wizardpb/2057-ICE40HX4K-TQ144-breakout/2057-ICE40HX4K-TQ144-breakout.kicad_pcb

## KiCad design 2057-ICE40HX4K-TQ144-breakout.kicad_pcb (2026-07-26)

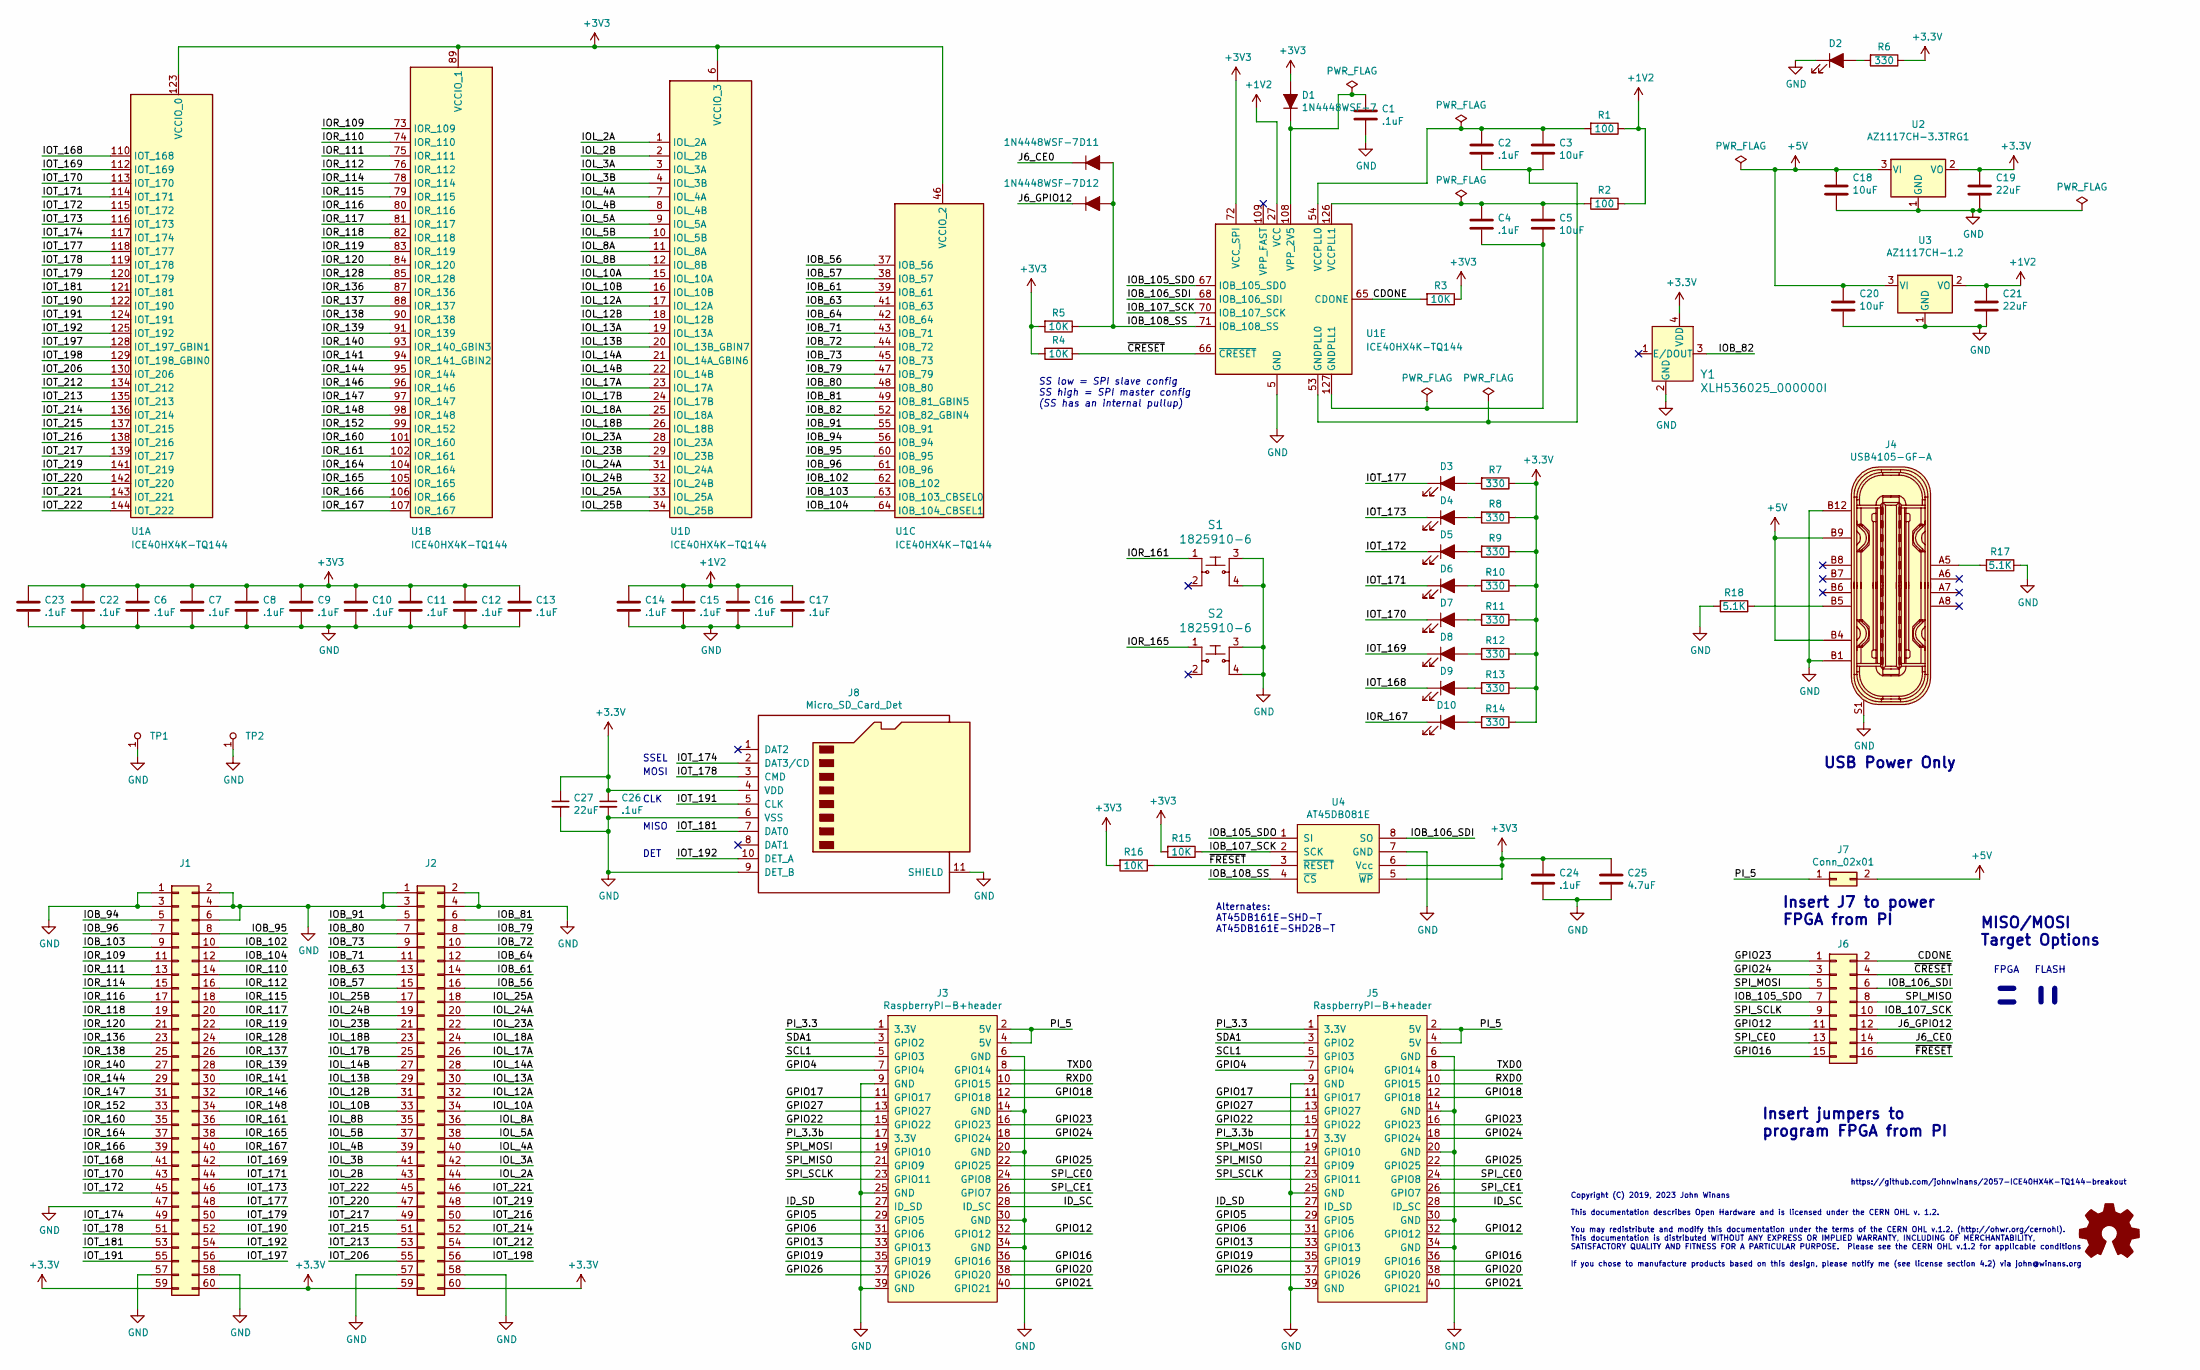
[picture p1: schematic 2057-ICE40HX4K-TQ144-breakout.kicad_sch]

Parts:
C1, C2, C4, C6, C7, C8, C9, C10, C11, C12, C13, C14, C15, C16, C17, C22, C23, C24: .1uF; C_0603_1608Metric_Pad1.05x0.95mm_HandSolder; MPN C1608X7R1H104K080AA; Digi-Key_PN 445-1314-1-ND
C3, C5: 10uF; C_0603_1608Metric_Pad1.05x0.95mm_HandSolder; MPN CL10A106MQ8NNNC; Digi-Key_PN 1276-1119-1-ND
C18, C20: 10uF; C_0805_2012Metric_Pad1.15x1.40mm_HandSolder; MPN CL10A106MQ8NNNC; Digi-Key_PN 1276-1119-1-ND
C19, C21, C27: 22uF; C_0805_2012Metric_Pad1.15x1.40mm_HandSolder; MPN CL10A226MQ8NRNE; Digi-Key_PN 1276-2868-1-ND
C25: 4.7uF; C_0603_1608Metric_Pad1.05x0.95mm_HandSolder; MPN CL10A475KQ8NNNC; Digi-Key_PN 1276-1045-1-ND
C26: .1uF; C_0805_2012Metric_Pad1.15x1.40mm_HandSolder; MPN C1608X7R1H104K080AA; Digi-Key_PN 445-1314-1-ND
D1, D11, D12: 1N4448WSF-7; D_0603_1608Metric_Pad1.05x0.95mm_HandSolder; MPN 1N4448WSF-7; Digi-Key_PN 1N4448WSF-7DICT-ND
D2, D3, D4, D5, D6, D7, D8, D9, D10: LED_ALT; LED_0603_1608Metric_Pad1.05x0.95mm_HandSolder; MPN B1911PG--20D000514U1930; Digi-Key_PN B1911PG--20D000514U1930
J1, J2: Conn_02x30_Odd_Even; PinHeader_2x30_P2.54mm_Vertical; MPN PRPC030DAAN-RC; Digi-Key_PN S2011EC-30-ND
J3, J5: RaspberryPI-B+header; PinHeader_2x20_P2.54mm_Vertical; MPN PRPC020DAAN-RC; Digi-Key_PN S2011EC-20-ND
J4: USB4105-GF-A; USB_C_Receptacle_HRO_TYPE-C-31-M-12; MPN USB4105-GF-A; Digi-Key_PN 2073-USB4105-GF-ATR-ND
J6: Conn_02x08_Odd_Even; PinHeader_2x08_P2.54mm_Vertical; MPN 10129381-916001BLF; Digi-Key_PN 10129381-916001BLF-ND
J7: Conn_02x01; PinHeader_2x01_P2.54mm_Vertical; MPN PH1-02-UA; Digi-Key_PN 2057-PH1-02-UA-ND
J8: Micro_SD_Card_Det; microSD_HC_Hirose_DM3D-SF-bigpad; MPN DM3D-SF; Digi-Key_PN HR1941CT-ND
LOGO1: Logo_Open_Hardware_Small; OSHW-Logo_11.4x12mm_SilkScreen
R1, R2: 100; R_0603_1608Metric_Pad1.05x0.95mm_HandSolder; MPN RC0603FR-07100RL; Digi-Key_PN 311-100HRCT-ND
R3, R4, R5, R15, R16: 10K; R_0603_1608Metric_Pad1.05x0.95mm_HandSolder; MPN RC0603FR-0710KL; Digi-Key_PN 311-10.0KHRCT-ND
R6, R7, R8, R9, R10, R11, R12, R13, R14: 330; R_0603_1608Metric_Pad1.05x0.95mm_HandSolder; MPN RC0603FR-07330RL; Digi-Key_PN 311-330HRCT-ND
R17, R18: 5.1K; R_0603_1608Metric_Pad1.05x0.95mm_HandSolder; MPN CR0603-FX-5101ELF; Digi-Key_PN CR0603-FX-5101ELFCT-ND
S1, S2: 1825910-6; Switch_Tactile_THT_6x6mm; MPN 1825910-6; Digi-Key_PN 450-1650-ND
TP1, TP2: RCWCTE; PROBE_PAD_1206; MPN RCWCTE; Digi-Key_PN 2019-RCWCTECT-ND
U1: ICE40HX4K-TQ144; TQFP-144_20x20mm_P0.5mm; MPN ICE40HX4K-TQ144; Digi-Key_PN 220-1572-ND
U2: AZ1117CH-3.3TRG1; SOT-223-3_TabPin2; MPN AZ1117CH-3.3TRG1; Digi-Key_PN AZ1117CH-3.3TRG1DICT-ND
U3: AZ1117CH-1.2; SOT-223-3_TabPin2; MPN AZ1117CH-1.2TRG1; Digi-Key_PN AZ1117CH-1.2TRG1DICT-ND
U4: AT45DB081E; SOIC-8_W5.6mm; MPN AT45DB081E-SSHNHC-T; Digi-Key_PN 1265-1092-1-ND
Y1: XLH536025_000000I; Oscillator_XLH536025.000000I; MPN XLH536025.000000I; Digi-Key_PN 631-1156-1-ND

Connections:
+1V2: C14.1, C15.1, C16.1, C17.1, C21.1, R1.1, R2.1, U1.27 (VCC), U1.40 (VCC), U1.92 (VCC), U1.111 (VCC), U3.2 (VO)
+5V: C18.1, C20.1, J4.A4, J4.A9, J4.B4, J4.B9, J7.2, U2.3 (VI), U3.3 (VI)
/CDONE: J6.2, R3.2, U1.65 (CDONE)
/GPIO4: J3.7 (GPIO4), J5.7 (GPIO4)
/GPIO5: J3.29 (GPIO5), J5.29 (GPIO5)
/GPIO6: J3.31 (GPIO6), J5.31 (GPIO6)
/GPIO12: J3.32 (GPIO12), J5.32 (GPIO12), J6.11
/GPIO13: J3.33 (GPIO13), J5.33 (GPIO13)
/GPIO16: J3.36 (GPIO16), J5.36 (GPIO16), J6.15
/GPIO17: J3.11 (GPIO17), J5.11 (GPIO17)
/GPIO18: J3.12 (GPIO18), J5.12 (GPIO18)
/GPIO19: J3.35 (GPIO19), J5.35 (GPIO19)
/GPIO20: J3.38 (GPIO20), J5.38 (GPIO20)
/GPIO21: J3.40 (GPIO21), J5.40 (GPIO21)
/GPIO22: J3.15 (GPIO22), J5.15 (GPIO22)
/GPIO23: J3.16 (GPIO23), J5.16 (GPIO23), J6.1
/GPIO24: J3.18 (GPIO24), J5.18 (GPIO24), J6.3
/GPIO25: J3.22 (GPIO25), J5.22 (GPIO25)
/GPIO26: J3.37 (GPIO26), J5.37 (GPIO26)
/GPIO27: J3.13 (GPIO27), J5.13 (GPIO27)
/ID_SC: J3.28 (ID_SC), J5.28 (ID_SC)
/ID_SD: J3.27 (ID_SD), J5.27 (ID_SD)
/IOB_56: J2.16, U1.37 (IOB_56)
/IOB_57: J2.15, U1.38 (IOB_57)
/IOB_61: J2.14, U1.39 (IOB_61)
/IOB_63: J2.13, U1.41 (IOB_63)
/IOB_64: J2.12, U1.42 (IOB_64)
/IOB_71: J2.11, U1.43 (IOB_71)
/IOB_72: J2.10, U1.44 (IOB_72)
/IOB_73: J2.9, U1.45 (IOB_73)
/IOB_79: J2.8, U1.47 (IOB_79)
/IOB_80: J2.7, U1.48 (IOB_80)
/IOB_81: J2.6, U1.49 (IOB_81_GBIN5)
/IOB_82: U1.52 (IOB_82_GBIN4), Y1.3 (OUT)
/IOB_91: J2.5, U1.55 (IOB_91)
/IOB_94: J1.5, U1.56 (IOB_94)
/IOB_95: J1.8, U1.60 (IOB_95)
/IOB_96: J1.7, U1.61 (IOB_96)
/IOB_102: J1.10, U1.62 (IOB_102)
/IOB_103: J1.9, U1.63 (IOB_103_CBSEL0)
/IOB_104: J1.12, U1.64 (IOB_104_CBSEL1)
/IOB_105_SDO: J6.7, U1.67 (IOB_105_SDO), U4.1 (SI)
/IOB_106_SDI: J6.6, U1.68 (IOB_106_SDI), U4.8 (SO)
/IOB_107_SCK: J6.10, R15.1, U1.70 (IOB_107_SCK), U4.2 (SCK)
/IOB_108_SS: D11.2 (A), D12.2 (A), R5.1, U1.71 (IOB_108_SS), U4.4 (~CS)
/IOL_2A: J2.44, U1.1 (IOL_2A)
/IOL_2B: J2.43, U1.2 (IOL_2B)
/IOL_3A: J2.42, U1.3 (IOL_3A)
/IOL_3B: J2.41, U1.4 (IOL_3B)
/IOL_4A: J2.40, U1.7 (IOL_4A)
/IOL_4B: J2.39, U1.8 (IOL_4B)
/IOL_5A: J2.38, U1.9 (IOL_5A)
/IOL_5B: J2.37, U1.10 (IOL_5B)
/IOL_8A: J2.36, U1.11 (IOL_8A)
/IOL_8B: J2.35, U1.12 (IOL_8B)
/IOL_10A: J2.34, U1.15 (IOL_10A)
/IOL_10B: J2.33, U1.16 (IOL_10B)
/IOL_12A: J2.32, U1.17 (IOL_12A)
/IOL_12B: J2.31, U1.18 (IOL_12B)
/IOL_13A: J2.30, U1.19 (IOL_13A)
/IOL_13B: J2.29, U1.20 (IOL_13B_GBIN7)
/IOL_14A: J2.28, U1.21 (IOL_14A_GBIN6)
/IOL_14B: J2.27, U1.22 (IOL_14B)
/IOL_17A: J2.26, U1.23 (IOL_17A)
/IOL_17B: J2.25, U1.24 (IOL_17B)
/IOL_18A: J2.24, U1.25 (IOL_18A)
/IOL_18B: J2.23, U1.26 (IOL_18B)
/IOL_23A: J2.22, U1.28 (IOL_23A)
/IOL_23B: J2.21, U1.29 (IOL_23B)
/IOL_24A: J2.20, U1.31 (IOL_24A)
/IOL_24B: J2.19, U1.32 (IOL_24B)
/IOL_25A: J2.18, U1.33 (IOL_25A)
/IOL_25B: J2.17, U1.34 (IOL_25B)
/IOR_109: J1.11, U1.73 (IOR_109)
/IOR_110: J1.14, U1.74 (IOR_110)
/IOR_111: J1.13, U1.75 (IOR_111)
/IOR_112: J1.16, U1.76 (IOR_112)
/IOR_114: J1.15, U1.78 (IOR_114)
/IOR_115: J1.18, U1.79 (IOR_115)
/IOR_116: J1.17, U1.80 (IOR_116)
/IOR_117: J1.20, U1.81 (IOR_117)
/IOR_118: J1.19, U1.82 (IOR_118)
/IOR_119: J1.22, U1.83 (IOR_119)
/IOR_120: J1.21, U1.84 (IOR_120)
/IOR_128: J1.24, U1.85 (IOR_128)
/IOR_136: J1.23, U1.87 (IOR_136)
/IOR_137: J1.26, U1.88 (IOR_137)
/IOR_138: J1.25, U1.90 (IOR_138)
/IOR_139: J1.28, U1.91 (IOR_139)
/IOR_140: J1.27, U1.93 (IOR_140_GBIN3)
/IOR_141: J1.30, U1.94 (IOR_141_GBIN2)
/IOR_144: J1.29, U1.95 (IOR_144)
/IOR_146: J1.32, U1.96 (IOR_146)
/IOR_147: J1.31, U1.97 (IOR_147)
/IOR_148: J1.34, U1.98 (IOR_148)
/IOR_152: J1.33, U1.99 (IOR_152)
/IOR_160: J1.35, U1.101 (IOR_160)
/IOR_161: J1.36, S1.1, U1.102 (IOR_161)
/IOR_164: J1.37, U1.104 (IOR_164)
/IOR_165: J1.38, S2.1, U1.105 (IOR_165)
/IOR_166: J1.39, U1.106 (IOR_166)
/IOR_167: D10.1 (K), J1.40, U1.107 (IOR_167)
/IOT_168: D9.1 (K), J1.41, U1.110 (IOT_168)
/IOT_169: D8.1 (K), J1.42, U1.112 (IOT_169)
/IOT_170: D7.1 (K), J1.43, U1.113 (IOT_170)
/IOT_171: D6.1 (K), J1.44, U1.114 (IOT_171)
/IOT_172: D5.1 (K), J1.45, U1.115 (IOT_172)
/IOT_173: D4.1 (K), J1.46, U1.116 (IOT_173)
/IOT_174: J1.49, J8.2 (DAT3/CD), U1.117 (IOT_174)
/IOT_177: D3.1 (K), J1.48, U1.118 (IOT_177)
/IOT_178: J1.51, J8.3 (CMD), U1.119 (IOT_178)
/IOT_179: J1.50, U1.120 (IOT_179)
/IOT_181: J1.53, J8.7 (DAT0), U1.121 (IOT_181)
/IOT_190: J1.52, U1.122 (IOT_190)
/IOT_191: J1.55, J8.5 (CLK), U1.124 (IOT_191)
/IOT_192: J1.54, J8.10 (DET_A), U1.125 (IOT_192)
/IOT_197: J1.56, U1.128 (IOT_197_GBIN1)
/IOT_198: J2.56, U1.129 (IOT_198_GBIN0)
/IOT_206: J2.55, U1.130 (IOT_206)
/IOT_212: J2.54, U1.134 (IOT_212)
/IOT_213: J2.53, U1.135 (IOT_213)
/IOT_214: J2.52, U1.136 (IOT_214)
/IOT_215: J2.51, U1.137 (IOT_215)
/IOT_216: J2.50, U1.138 (IOT_216)
/IOT_217: J2.49, U1.139 (IOT_217)
/IOT_219: J2.48, U1.141 (IOT_219)
/IOT_220: J2.47, U1.142 (IOT_220)
/IOT_221: J2.46, U1.143 (IOT_221)
/IOT_222: J2.45, U1.144 (IOT_222)
/J6_CE0: D11.1 (K), J6.14
/J6_GPIO12: D12.1 (K), J6.12
/PI_3.3: J3.1 (3.3V), J5.1 (3.3V)
/PI_3.3b: J3.17 (3.3V), J5.17 (3.3V)
/PI_5: J3.2 (5V), J3.4 (5V), J5.2 (5V), J5.4 (5V), J7.1
/RXD0: J3.10 (GPIO15), J5.10 (GPIO15)
/SCL1: J3.5 (GPIO3), J5.5 (GPIO3)
/SDA1: J3.3 (GPIO2), J5.3 (GPIO2)
/SPI_CE0: J3.24 (GPIO8), J5.24 (GPIO8), J6.13
/SPI_CE1: J3.26 (GPIO7), J5.26 (GPIO7)
/SPI_MISO: J3.21 (GPIO9), J5.21 (GPIO9), J6.8
/SPI_MOSI: J3.19 (GPIO10), J5.19 (GPIO10), J6.5
/SPI_SCLK: J3.23 (GPIO11), J5.23 (GPIO11), J6.9
/TXD0: J3.8 (GPIO14), J5.8 (GPIO14)
/~CRESET: J6.4, R4.1, U1.66 (~CRESET)
/~FRESET: J6.16, R16.1, U4.3 (~RESET)
GND: C1.2, C6.2, C7.2, C8.2, C9.2, C10.2, C11.2, C12.2, C13.2, C14.2, C15.2, C16.2, C17.2, C18.2, C19.2, C20.2, C21.2, C22.2, C23.2, C24.2, C25.2, C26.2, C27.2, D2.1 (K), J1.1, J1.2, J1.3, J1.4, J1.6, J1.47, J1.57, J1.58, J2.1, J2.2, J2.3, J2.4, J2.57, J2.58, J3.6 (GND), J3.9 (GND), J3.14 (GND), J3.20 (GND), J3.25 (GND), J3.30 (GND), J3.34 (GND), J3.39 (GND), J4.A1, J4.A12, J4.B1, J4.B12, J4.S1, J5.6 (GND), J5.9 (GND), J5.14 (GND), J5.20 (GND), J5.25 (GND), J5.30 (GND), J5.34 (GND), J5.39 (GND), J8.6 (VSS), J8.9 (DET_B), J8.11 (SHIELD), R17.1, R18.2, S1.3, S1.4, S2.3, S2.4, TP1.1, TP2.1, U1.5 (GND), U1.13 (GND), U1.14 (GND), U1.59 (GND), U1.69 (GND), U1.86 (GND), U1.103 (GND), U1.132 (GND), U1.140 (GND), U2.1 (GND), U3.1 (GND), U4.7 (GND), Y1.2 (GND)
unnamed: C1.1, D1.1 (K), U1.108 (VPP_2V5)
unnamed: C2.1, C3.1, R1.2, U1.54 (VCCPLL0)
unnamed: C2.2, C3.2, U1.53 (GNDPLL0)
unnamed: C4.1, C5.1, R2.2, U1.126 (VCCPLL1)
unnamed: C4.2, C5.2, U1.127 (GNDPLL1)
unnamed: D2.2 (A), R6.2
unnamed: D3.2 (A), R7.2
unnamed: D4.2 (A), R8.2
unnamed: D5.2 (A), R9.2
unnamed: D6.2 (A), R10.2
unnamed: D7.2 (A), R11.2
unnamed: D8.2 (A), R12.2
unnamed: D9.2 (A), R13.2
unnamed: D10.2 (A), R14.2
unnamed: J4.A5, R17.2
unnamed: J4.B5, R18.1

Notes on the sheet:
Insert jumpers to program FPGA from PI
USB Power Only
CLK
Insert J7 to power FPGA from PI
Alternates: AT45DB161E-SHD-T AT45DB161E-SHD2B-T
DET
Copyright (C) 2019, 2023 John Winans This documentation describes Open Hardware and is licensed under the CERN OHL v. 1.2. You may redistribute and modify this documentation under the terms of the CERN OHL v.1.2. (http://ohwr.org/cernohl). This documentation is distributed WITHOUT ANY EXPRESS OR IM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
FPGA
MOSI
FLASH
SS low = SPI slave config SS high = SPI master config (SS has an internal pullup)
MISO/MOSI Target Options
MISO
SSEL
https://github.com/johnwinans/2057-ICE40HX4K-TQ144-breakout

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
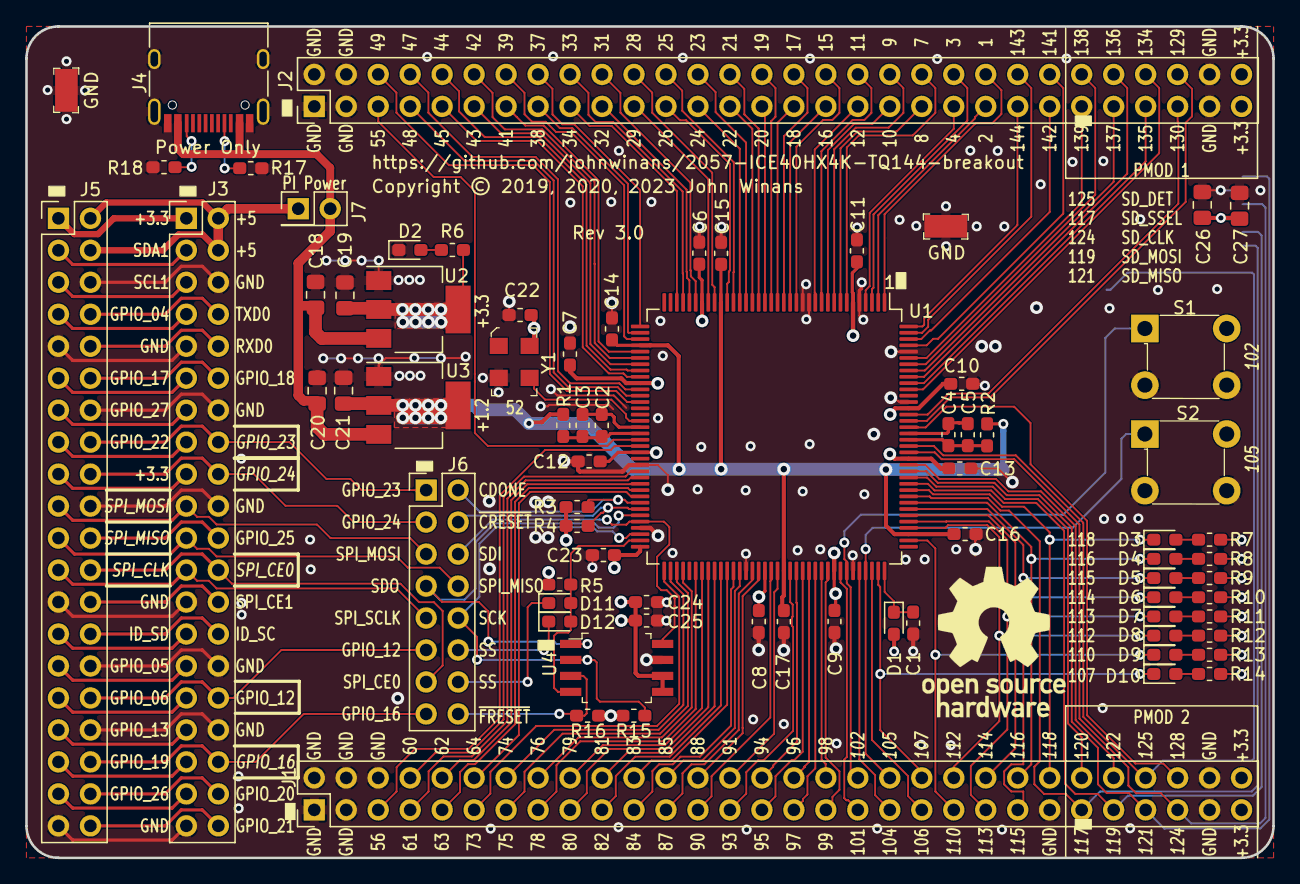
[picture p2: board 2057-ICE40HX4K-TQ144-breakout.kicad_pcb from above]

Board: 4 copper layers, 99.1 x 66.0 mm, 75 parts (1 on the bottom side), 163 nets.
