wizardpb/2057-ICE40HX4K-TQ144-breakout/(commit log)

2026-07-25 Update to KiCad version 10 format
    [2057-ICE40HX4K-TQ144-breakout.kicad_pcb, 2057-ICE40HX4K-TQ144-breakout.kicad_sch]
2026-07-26 Fix power vias
    [2057-ICE40HX4K-TQ144-breakout.kicad_pcb]
2026-07-26 Fix co-linear tracks
    [2057-ICE40HX4K-TQ144-breakout.kicad_pcb]
2026-07-26 Updated gerbers+drill files
    [2057-ICE40HX4K-TQ144-breakout-B_Cu.gbl, 2057-ICE40HX4K-TQ144-breakout-B_Mask.gbs, 2057-ICE40HX4K-TQ144-breakout-B_Paste.gbp, 2057-ICE40HX4K-TQ144-breakout-B_SilkS.gbo, 2057-ICE40HX4K-TQ144-breakout-B_Silkscreen.gbo, 2057-ICE40HX4K-TQ144-breakout-Edge_Cuts.gm1, 2057-ICE40HX4K-TQ144-breakout-F_Cu.gtl, 2057-ICE40HX4K-TQ144-breakout-F_Mask.gts]
2026-07-27 Fix DRC error: Unify +3.3V and +3V3 nets
    [2057-ICE40HX4K-TQ144-breakout.kicad_sch]
