wizardpb/2057-ICE40HX4K-TQ144-breakout/(notices)

Notices in the files:
2057-ICE40HX4K-TQ144-breakout.kicad_pcb:
Copyright © 2019, 2020, 2023 John Winans
2057-ICE40HX4K-TQ144-breakout.kicad_sch:
If you chose to manufacture products based on this design, please notify me (see license section 4.2) via john@winans.org
